MarJong/ECCO-Matrix/Bilder/metalldetektor.png

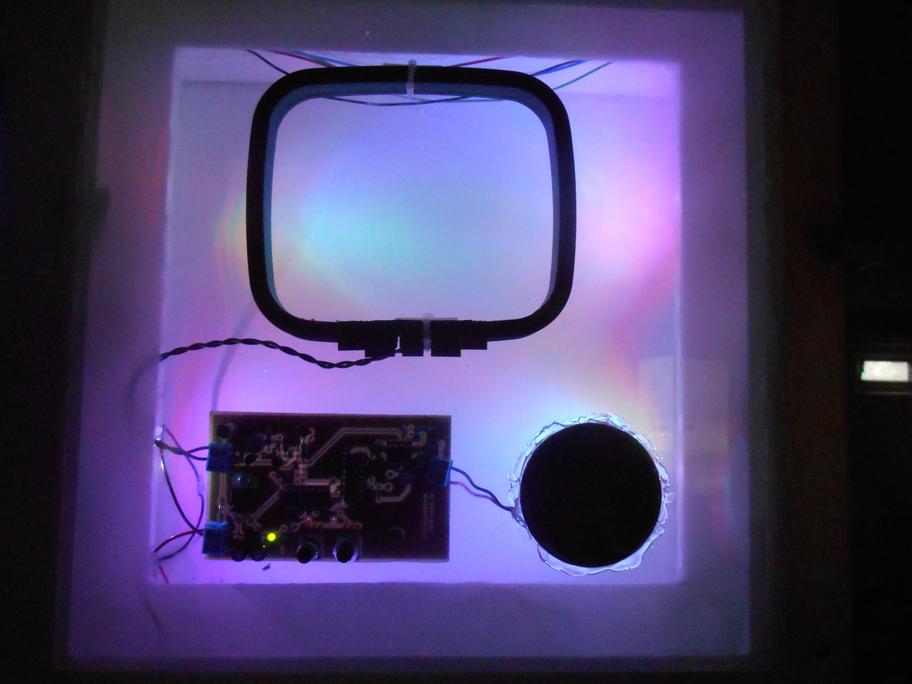
Bilder/metalldetektor.png
