MarJong/ECCO-Matrix/Bilder/mit gestrichener wand.png

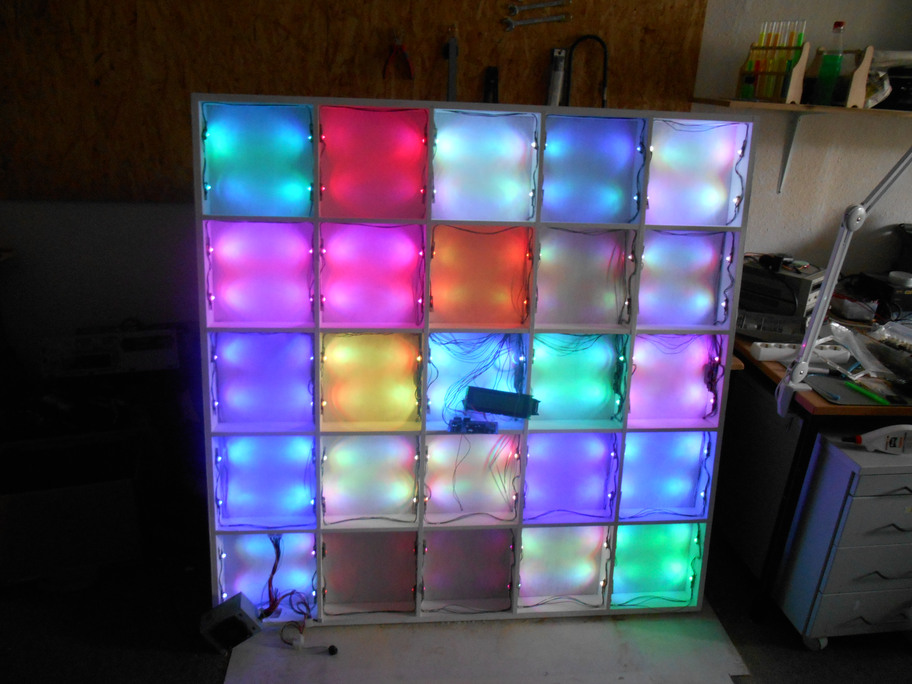
Bilder/mit gestrichener wand.png
