MarJong/ECCO-Matrix/README.md

# ECCO-Matrix
Archiv der Daten zum LED Matrix Ausstellungsstück des Elektronik Club Cottbus (ECCO)
