MarJong/ECCO-Matrix/Bilder/fertig 2.png

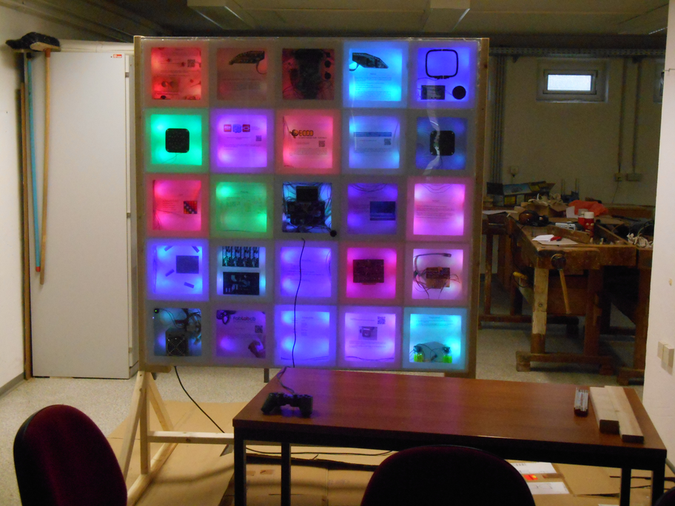
Bilder/fertig 2.png
