MarJong/ECCO-Matrix/Bilder/fertig .png

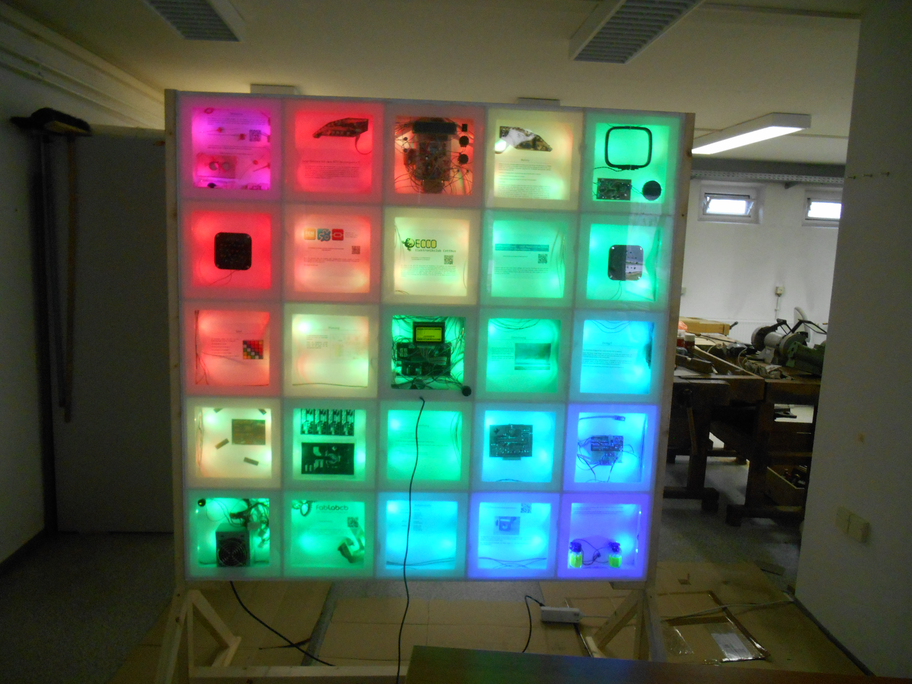
Bilder/fertig .png
