MarJong/ECCO-Matrix/Bilder/Hauptmenü.png

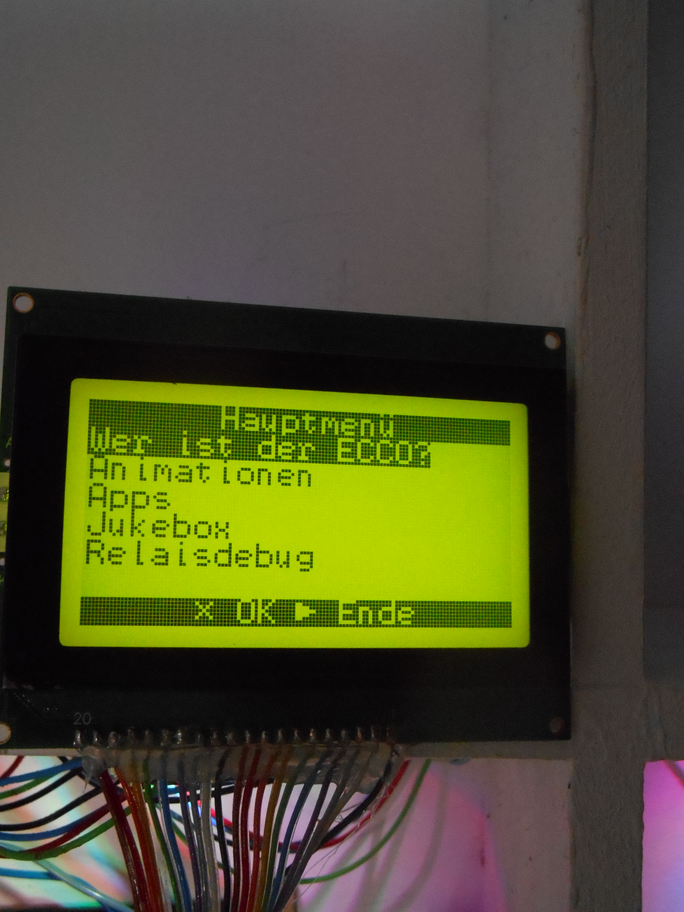
Bilder/Hauptmenü.png
