MarJong/ECCO-Matrix/Bilder/Hauptplatine 2.png

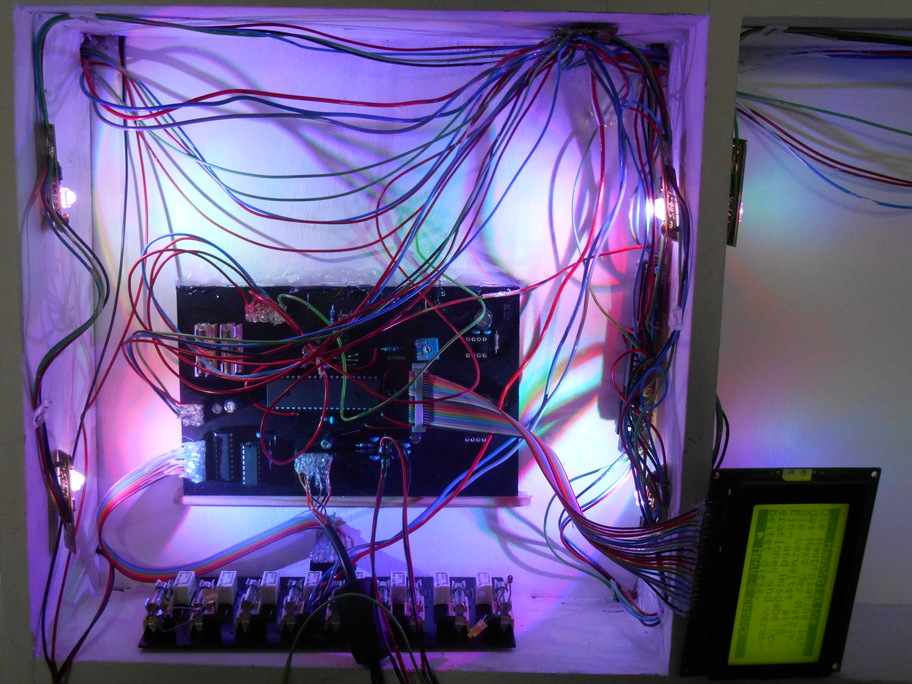
Bilder/Hauptplatine 2.png
