MarJong/ECCO-Matrix/Bilder/Hauptplatine.png

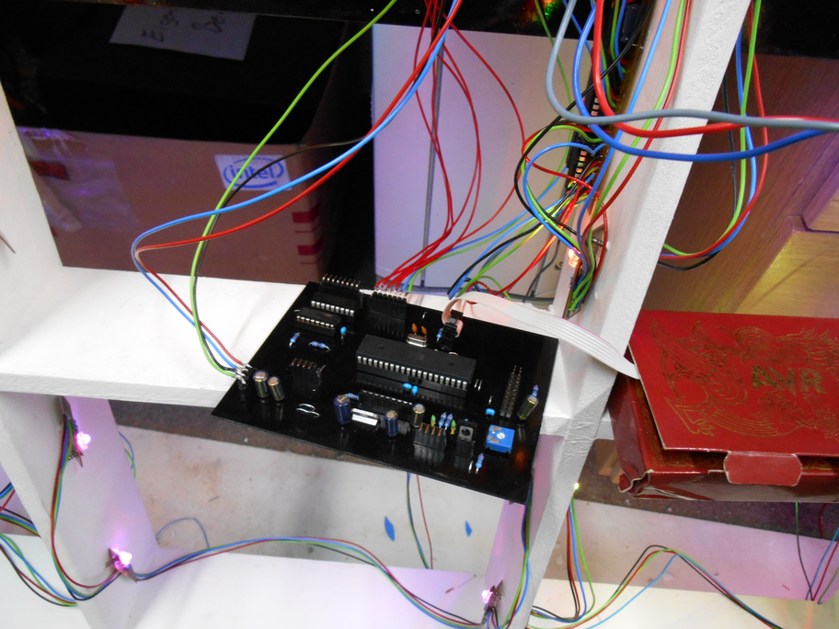
Bilder/Hauptplatine.png
