MarJong/ECCO-Matrix/Bilder/Matrix 1.png

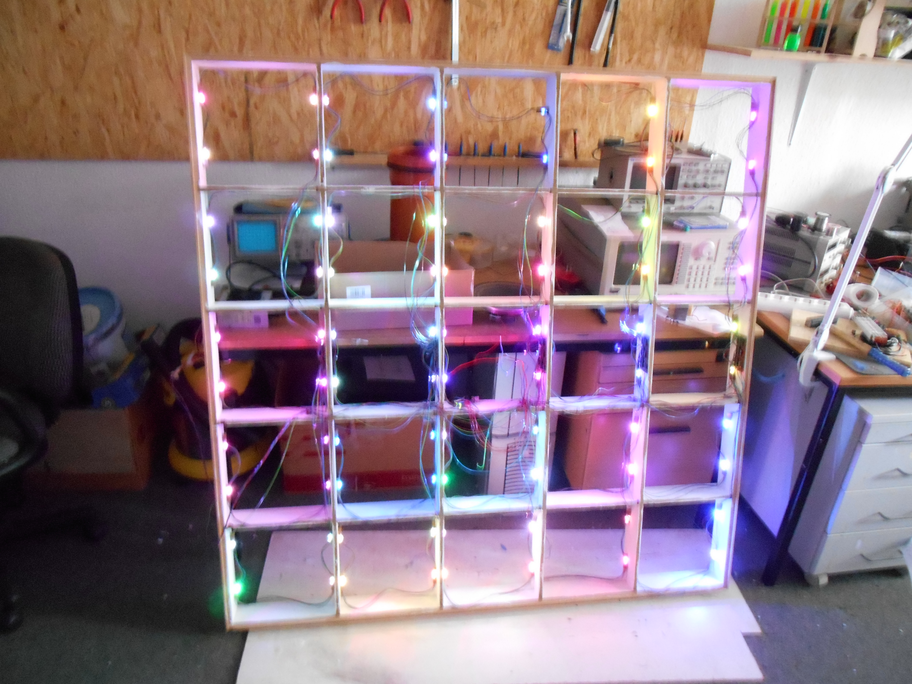
Bilder/Matrix 1.png
