MarJong/ECCO-Matrix/Bilder/Matrix 3.png

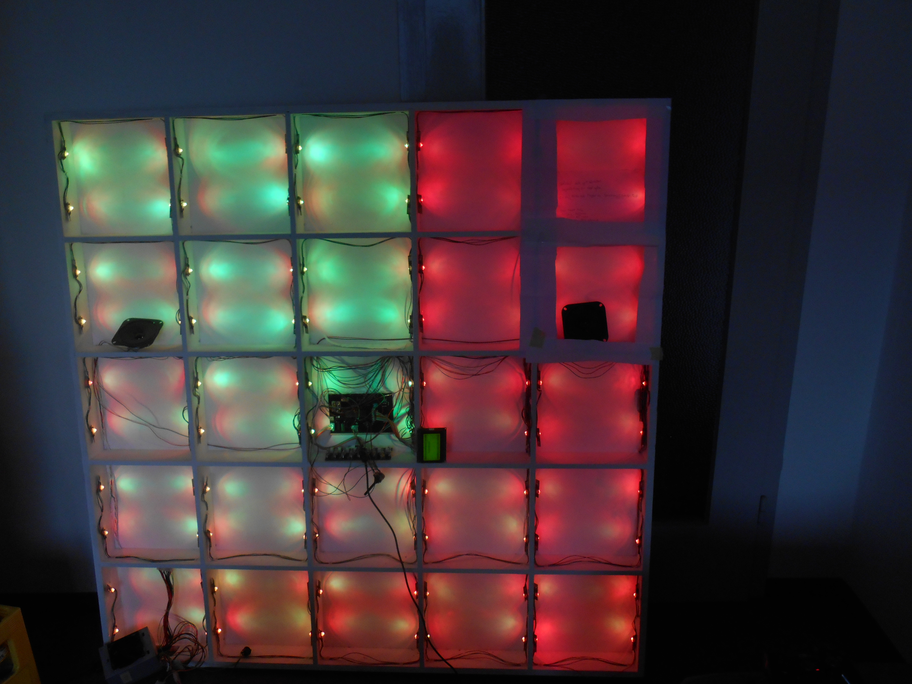
Bilder/Matrix 3.png
