MarJong/ECCO-Matrix/Bilder/Matrix Feld.png

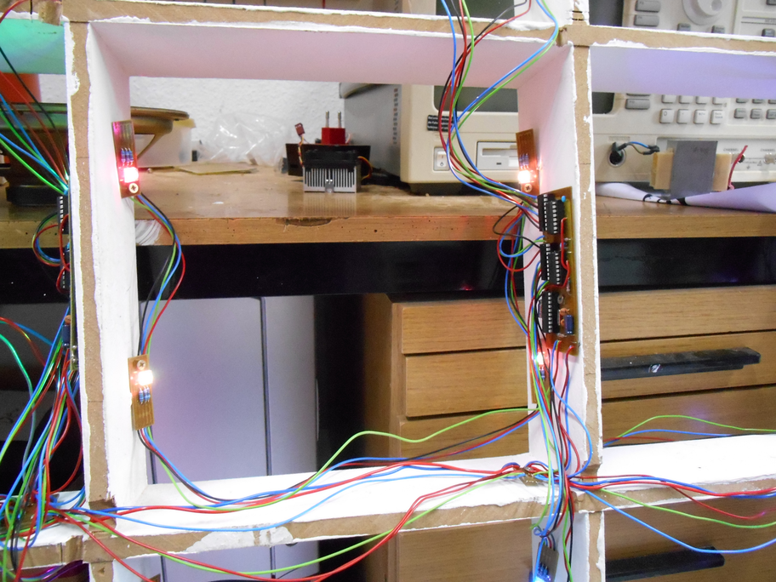
Bilder/Matrix Feld.png
