MarJong/ECCO-Matrix/Bilder/matrix mit rückwand.png

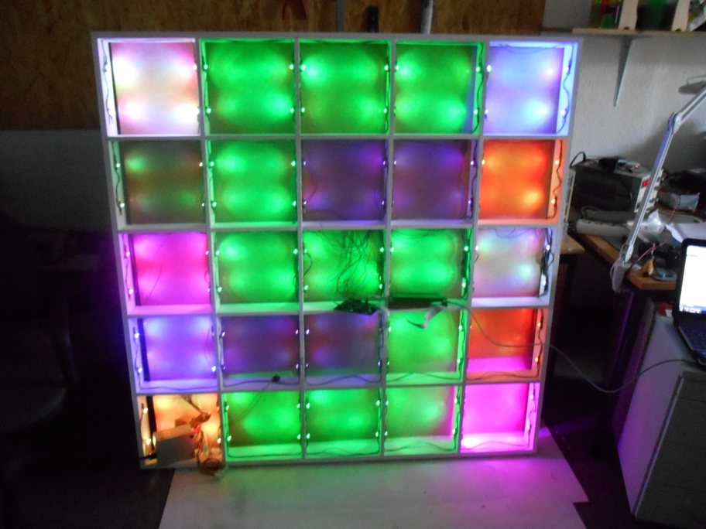
Bilder/matrix mit rückwand.png
