MarJong/ECCO-Matrix/Bilder/melete.png

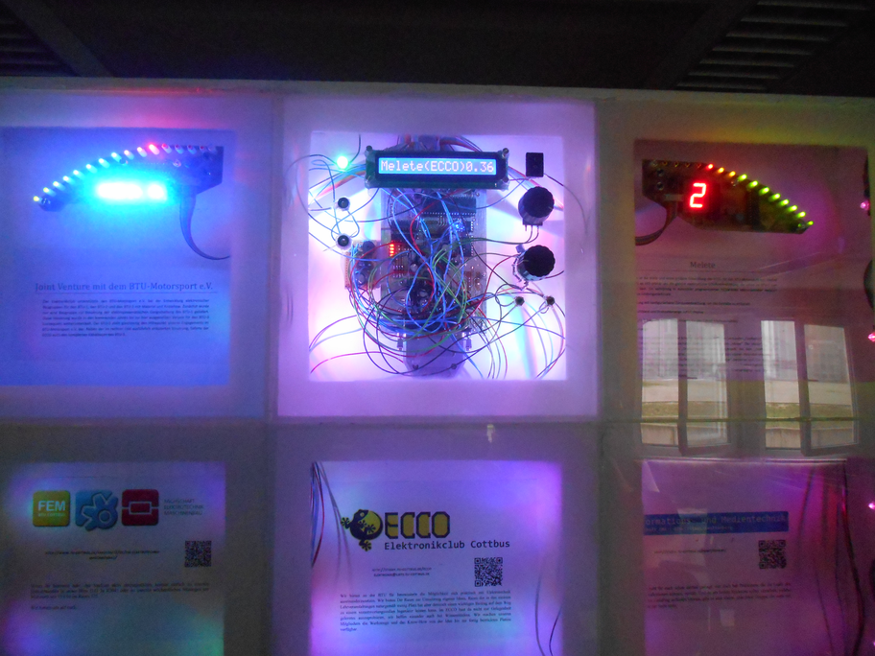
Bilder/melete.png
