MarJong/ECCO-Matrix/Bilder/mit farbe - ohne farbe.png

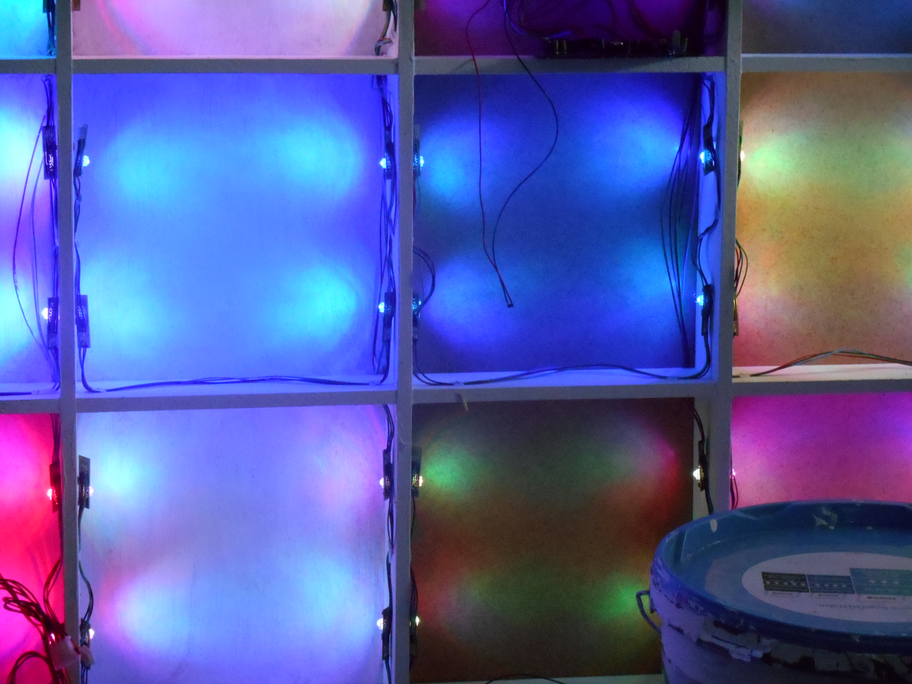
Bilder/mit farbe - ohne farbe.png
