MarJong/ECCO-Matrix/Bilder/Netzteil.png

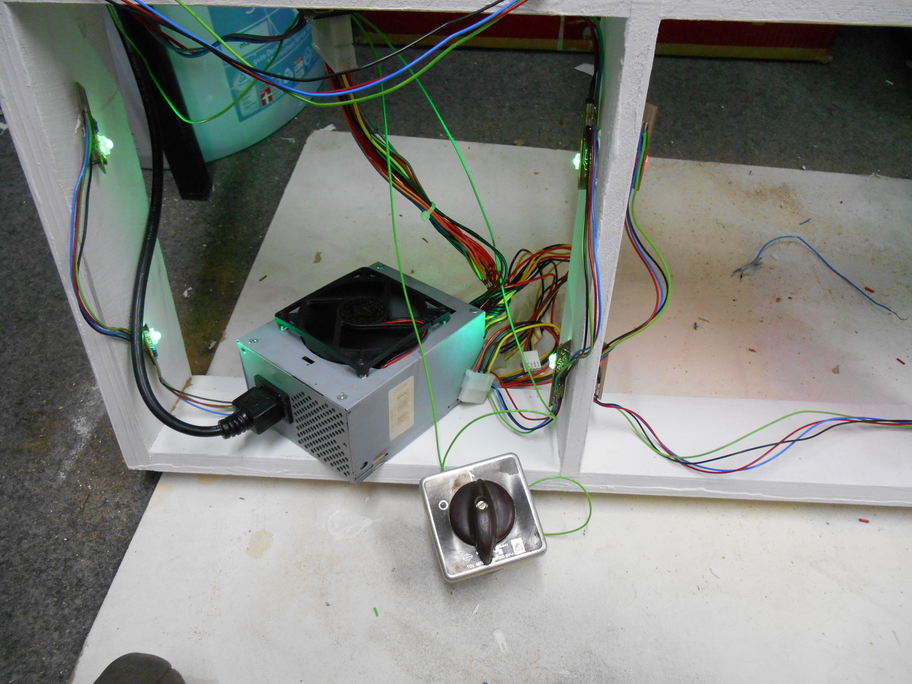
Bilder/Netzteil.png
