MarJong/ECCO-Matrix/Bilder/PWM Controller.png

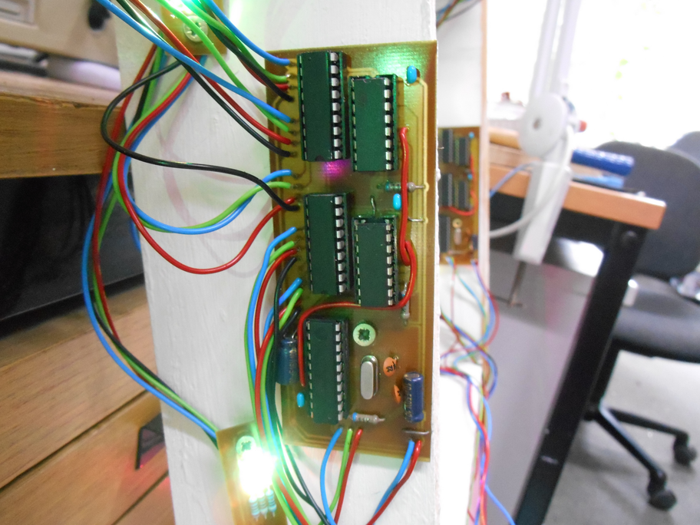
Bilder/PWM Controller.png
