MarJong/ECCO-Matrix/Bilder/uv dinger.png

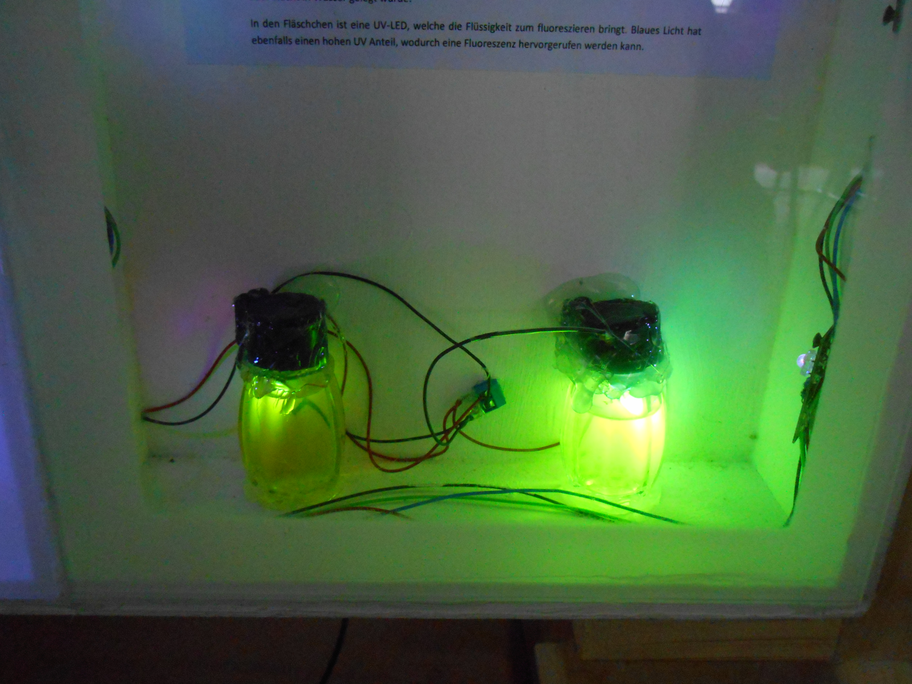
Bilder/uv dinger.png
