MarJong/ECCO-Matrix/Hardware/matrix - master.png

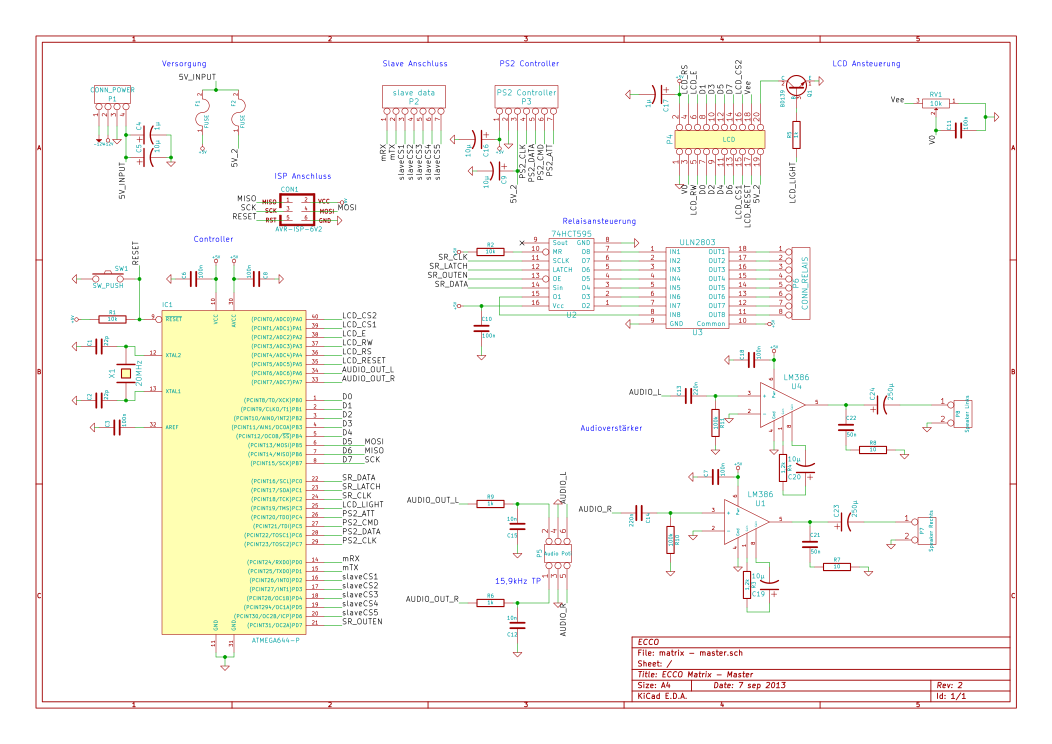
Hardware/matrix - master.png
