MarJong/ECCO-Matrix/Hardware/matrix - slave.png

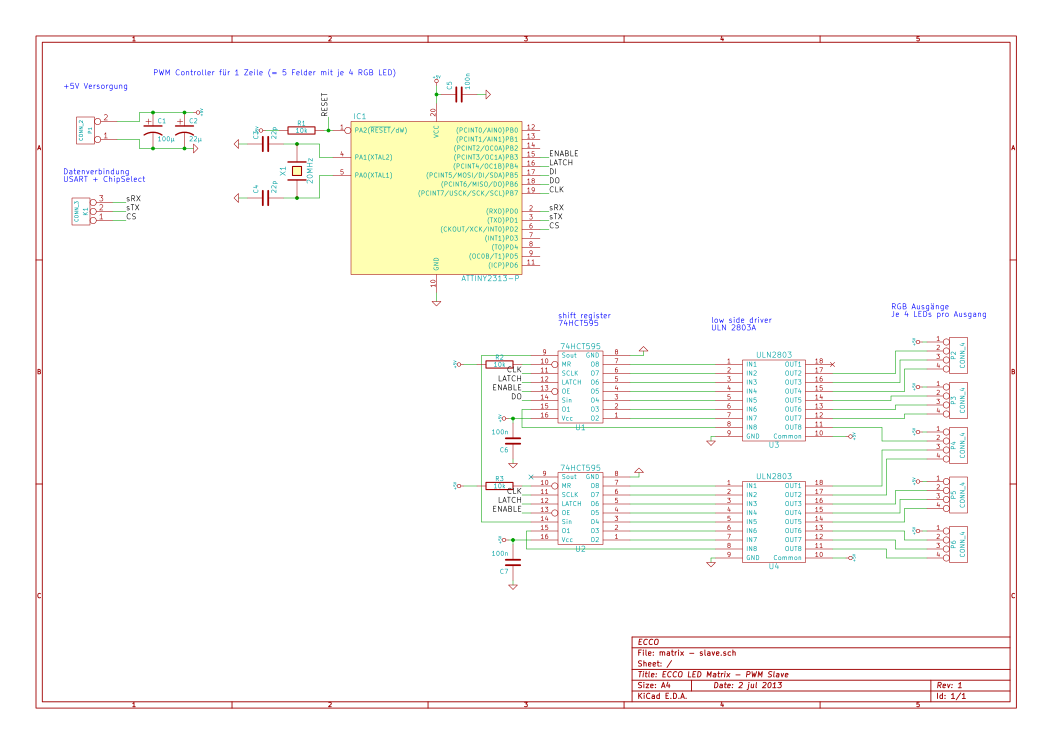
Hardware/matrix - slave.png
