MarJong/ECCO-Matrix/Hardware/matrix - master.pdf

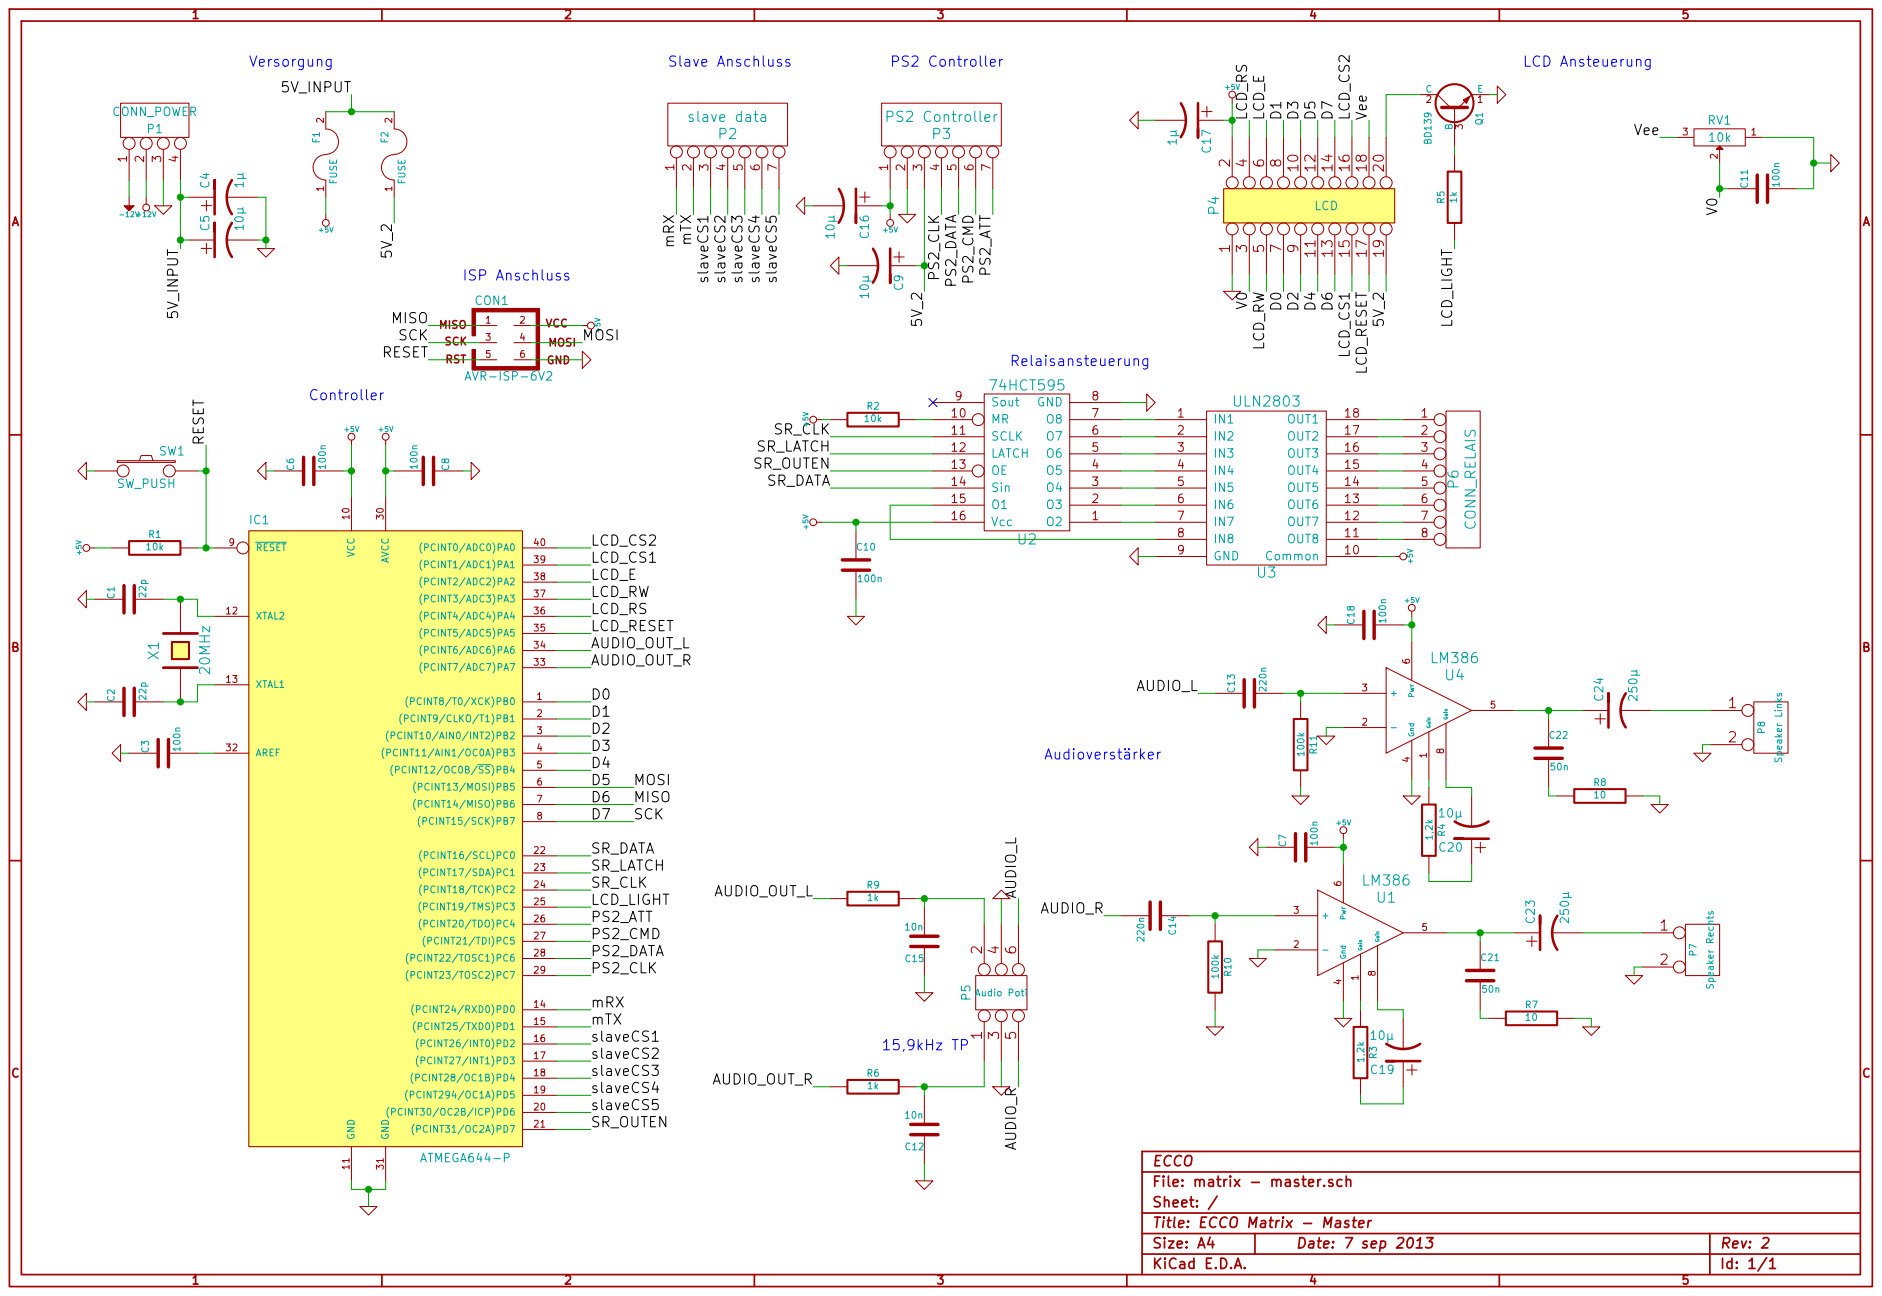
[picture p19: page 1]

IN2 2 | 2
IN3 3 | 3

IN5 5 | 5
IN6 6 | 6
IN7 7 | 7

ECCO
Title: ECCO Matrix - Master File: matrix - master.sch Sheet: /
