MarJong/ECCO-Matrix/Hardware/matrix - master.sch

## KiCad design Hardware/matrix - master.sch (2023-09-17)

Schematic: matrix - master.sch

Parts:
5V: Batterie
C1, C2: 22p
C3, C6, C7, C8, C10, C11, C18: 100n
C4, C17: 1µ
C5, C9, C16, C19, C20: 10µ
C12, C15: 10n
C13, C14: 220n
C21, C22: 50n
C23, C24: 250µ
CON1: AVR-ISP-6V2; AVR-ISP-6
F1, F2: FUSE
IC1: ATMEGA644-P; DIL40
P1: CONN_POWER
P2: slave data
P3: PS2 Controller
P4: LCD
P5: Audio Poti
P6: CONN_RELAIS
P7: Speaker Rechts
P8: Speaker Links
Q1: BD139; TO126
R1, R2: 10k
R3, R4: 1,2k
R5, R6, R9: 1k
R7, R8: 10
R10, R11: 100k
RV1: 10k
SW1: SW_PUSH
U1, U4: LM386
U2: 74HCT595
U3: ULN2803
X1: 20MHz

Notes on the sheet:
Controller
Versorgung
Slave Anschluss
PS2 Controller
Relaisansteuerung
LCD Ansteuerung
ISP Anschluss
15,9kHz TP
Audioverstärker
