MarJong/ECCO-Matrix/Hardware/matrix - relais.sch

## KiCad design Hardware/matrix - relais.sch (2023-09-17)


Parts:
F1, F2, F3, F4, F5, F6, F7, F8, F9, F10, F11, F12, F13, F14, F15, F16: FUSE
K1: CONN_POWER
K2, K3, K4, K5, K6, K7, K8, K9: CONN_OUT
P1: CONN_INPUT
R1: 10
R2: 20
RL1, RL2, RL3, RL4, RL5, RL6, RL7, RL8: FINDER-30.22

Connections:
5V_MASSE: R1.2, RL1.12, RL2.12, RL3.12, RL4.12, RL5.12, RL6.12, RL7.12, RL8.12
12V_MASSE: R2.2, RL1.22, RL2.22, RL3.22, RL4.22, RL5.22, RL6.22, RL7.22, RL8.22
+5V: K1.3, RL1.14, RL1.A1, RL2.14, RL2.A1, RL3.14, RL3.A1, RL4.14, RL4.A1, RL5.14, RL5.A1, RL6.14, RL6.A1, RL7.14, RL7.A1, RL8.14, RL8.A1
+12V: K1.2 (PM), RL1.24, RL2.24, RL3.24, RL4.24, RL5.24, RL6.24, RL7.24, RL8.24
GND: K1.1, K2.2 (PM), K3.2 (PM), K4.2 (PM), K5.2 (PM), K6.2 (PM), K7.2 (PM), K8.2 (PM), K9.2 (PM), R1.1, R2.1
IN1: P1.8, RL1.A2
IN2: P1.7, RL2.A2
IN3: P1.6, RL3.A2
IN4: P1.5, RL4.A2
IN5: P1.4, RL5.A2
IN6: P1.3, RL6.A2
IN7: P1.2, RL7.A2
IN8: P1.1, RL8.A2
unnamed: F1.1, RL1.21
unnamed: F1.2, K2.1
unnamed: F2.1, RL1.11
unnamed: F2.2, K2.3
unnamed: F3.1, RL2.21
unnamed: F3.2, K3.1
unnamed: F4.1, RL2.11
unnamed: F4.2, K3.3
unnamed: F5.1, RL3.21
unnamed: F5.2, K4.1
unnamed: F6.1, RL3.11
unnamed: F6.2, K4.3
unnamed: F7.1, RL4.21
unnamed: F7.2, K5.1
unnamed: F8.1, RL4.11
unnamed: F8.2, K5.3
unnamed: F9.1, RL5.21
unnamed: F9.2, K6.1
unnamed: F10.1, RL5.11
unnamed: F10.2, K6.3
unnamed: F11.1, RL6.21
unnamed: F11.2, K7.1
unnamed: F12.1, RL6.11
unnamed: F12.2, K7.3
unnamed: F13.1, RL7.21
unnamed: F13.2, K8.1
unnamed: F14.1, RL7.11
unnamed: F14.2, K8.3
unnamed: F15.1, RL8.21
unnamed: F15.2, K9.1
unnamed: F16.1, RL8.11
unnamed: F16.2, K9.3

Notes on the sheet:
Input
Versorgung
Absicherung Masse
