MarJong/ECCO-Matrix/Hardware/matrix - slave.sch

## KiCad design Hardware/matrix - slave.sch (2023-09-17)


Parts:
C1: 100µ
C2: 22µ
C3, C4: 22p
C5, C6, C7: 100n
IC1: ATTINY2313-P; DIP20
K1: CONN_3
P1: CONN_2
P2, P3, P4, P5, P6: CONN_4
R1, R2, R3: 10k
U1, U2: 74HCT595
U3, U4: ULN2803
X1: 20MHz

Connections:
+5V: C1.1, C2.1, C5.1, C6.2, C7.2, IC1.20 (VCC), P1.2 (PM), P2.1, P3.1, P4.1, P5.1, P6.1, R1.1, R2.1, R3.1, U1.16 (Vcc), U2.16 (Vcc), U3.10 (Common), U4.10 (Common)
CLK: IC1.19 ((PCINT7/USCK/SCK/SCL)PB7), U1.11 (SCLK), U2.11 (SCLK)
CS: IC1.6 ((CKOUT/XCK/INT0)PD2), K1.1
DI: IC1.17 ((PCINT5/MOSI/DI/SDA)PB5)
DO: IC1.18 ((PCINT6/MISO/DO)PB6), U1.14 (Sin)
ENABLE: IC1.15 ((PCINT3/OC1A)PB3), U1.13 (OE), U2.13 (OE)
GND: C1.2, C2.2, C3.1, C4.1, C5.2, C6.1, C7.1, IC1.10 (GND), P1.1, U1.8 (GND), U2.8 (GND), U3.9 (GND), U4.9 (GND)
LATCH: IC1.16 ((PCINT4/OC1B)PB4), U1.12 (LATCH), U2.12 (LATCH)
unnamed: C3.2, IC1.4 (PA1(XTAL2)), X1.2
unnamed: C4.2, IC1.5 (PA0(XTAL1)), X1.1
unnamed: P2.2, U3.17 (OUT2)
unnamed: P2.3, U3.16 (OUT3)
unnamed: P2.4, U3.15 (OUT4)
unnamed: P3.2, U3.14 (OUT5)
unnamed: P3.3, U3.13 (OUT6)
unnamed: P3.4, U3.12 (OUT7)
unnamed: P4.2, U3.11 (OUT8)
unnamed: P4.3, U4.18 (OUT1)
unnamed: P4.4, U4.17 (OUT2)
unnamed: P5.2, U4.16 (OUT3)
unnamed: P5.3, U4.15 (OUT4)
unnamed: P5.4, U4.14 (OUT5)
unnamed: P6.2, U4.13 (OUT6)
unnamed: P6.3, U4.12 (OUT7)
unnamed: P6.4, U4.11 (OUT8)
unnamed: R2.2, U1.10 (MR)
unnamed: R3.2, U2.10 (MR)
unnamed: U1.1 (O2), U3.7 (IN7)
unnamed: U1.2 (O3), U3.6 (IN6)
unnamed: U1.3 (O4), U3.5 (IN5)
unnamed: U1.4 (O5), U3.4 (IN4)
unnamed: U1.5 (O6), U3.3 (IN3)
unnamed: U1.6 (O7), U3.2 (IN2)
unnamed: U1.7 (O8), U3.1 (IN1)
unnamed: U1.9 (Sout), U2.14 (Sin)
unnamed: U1.15 (O1), U3.8 (IN8)
unnamed: U2.1 (O2), U4.7 (IN7)
unnamed: U2.2 (O3), U4.6 (IN6)
unnamed: U2.3 (O4), U4.5 (IN5)
unnamed: U2.4 (O5), U4.4 (IN4)
unnamed: U2.5 (O6), U4.3 (IN3)
unnamed: U2.6 (O7), U4.2 (IN2)
unnamed: U2.7 (O8), U4.1 (IN1)
unnamed: U2.15 (O1), U4.8 (IN8)
RESET: IC1.1 (PA2(~RESET~/dW)), R1.2
sRX: IC1.2 ((RXD)PD0), K1.3
sTX: IC1.3 ((TXD)PD1), K1.2 (PM)

Notes on the sheet:
shift register 74HCT595
low side driver ULN 2803A
Datenverbindung USART + ChipSelect
+5V Versorgung
RGB Ausgänge Je 4 LEDs pro Ausgang
PWM Controller für 1 Zeile (= 5 Felder mit je 4 RGB LED)
