MarJong/ECCO-Matrix/Hardware/matrix - stromanschluss.sch

## KiCad design Hardware/matrix - stromanschluss.sch (2023-09-17)


Parts:
P1: CONN_10X2
P2: CONN_5
P3: Switch
P4: CONN_1

Connections:
+3,3V: P1.17, P1.19, P1.20, P2.5
+5V: P1.2, P1.4, P1.9, P1.13, P2.3
+12V: P1.1, P2.1
-12V: P1.18, P2.4
GND: P1.7, P1.8, P1.10, P1.11, P1.12, P1.15, P1.16, P2.2, P3.2 (PM)
PS_ON: P1.14, P3.1
