MarJong/ECCO-Matrix/Hardware/matrix - verbinder.sch

## KiCad design Hardware/matrix - verbinder.sch (2023-09-17)

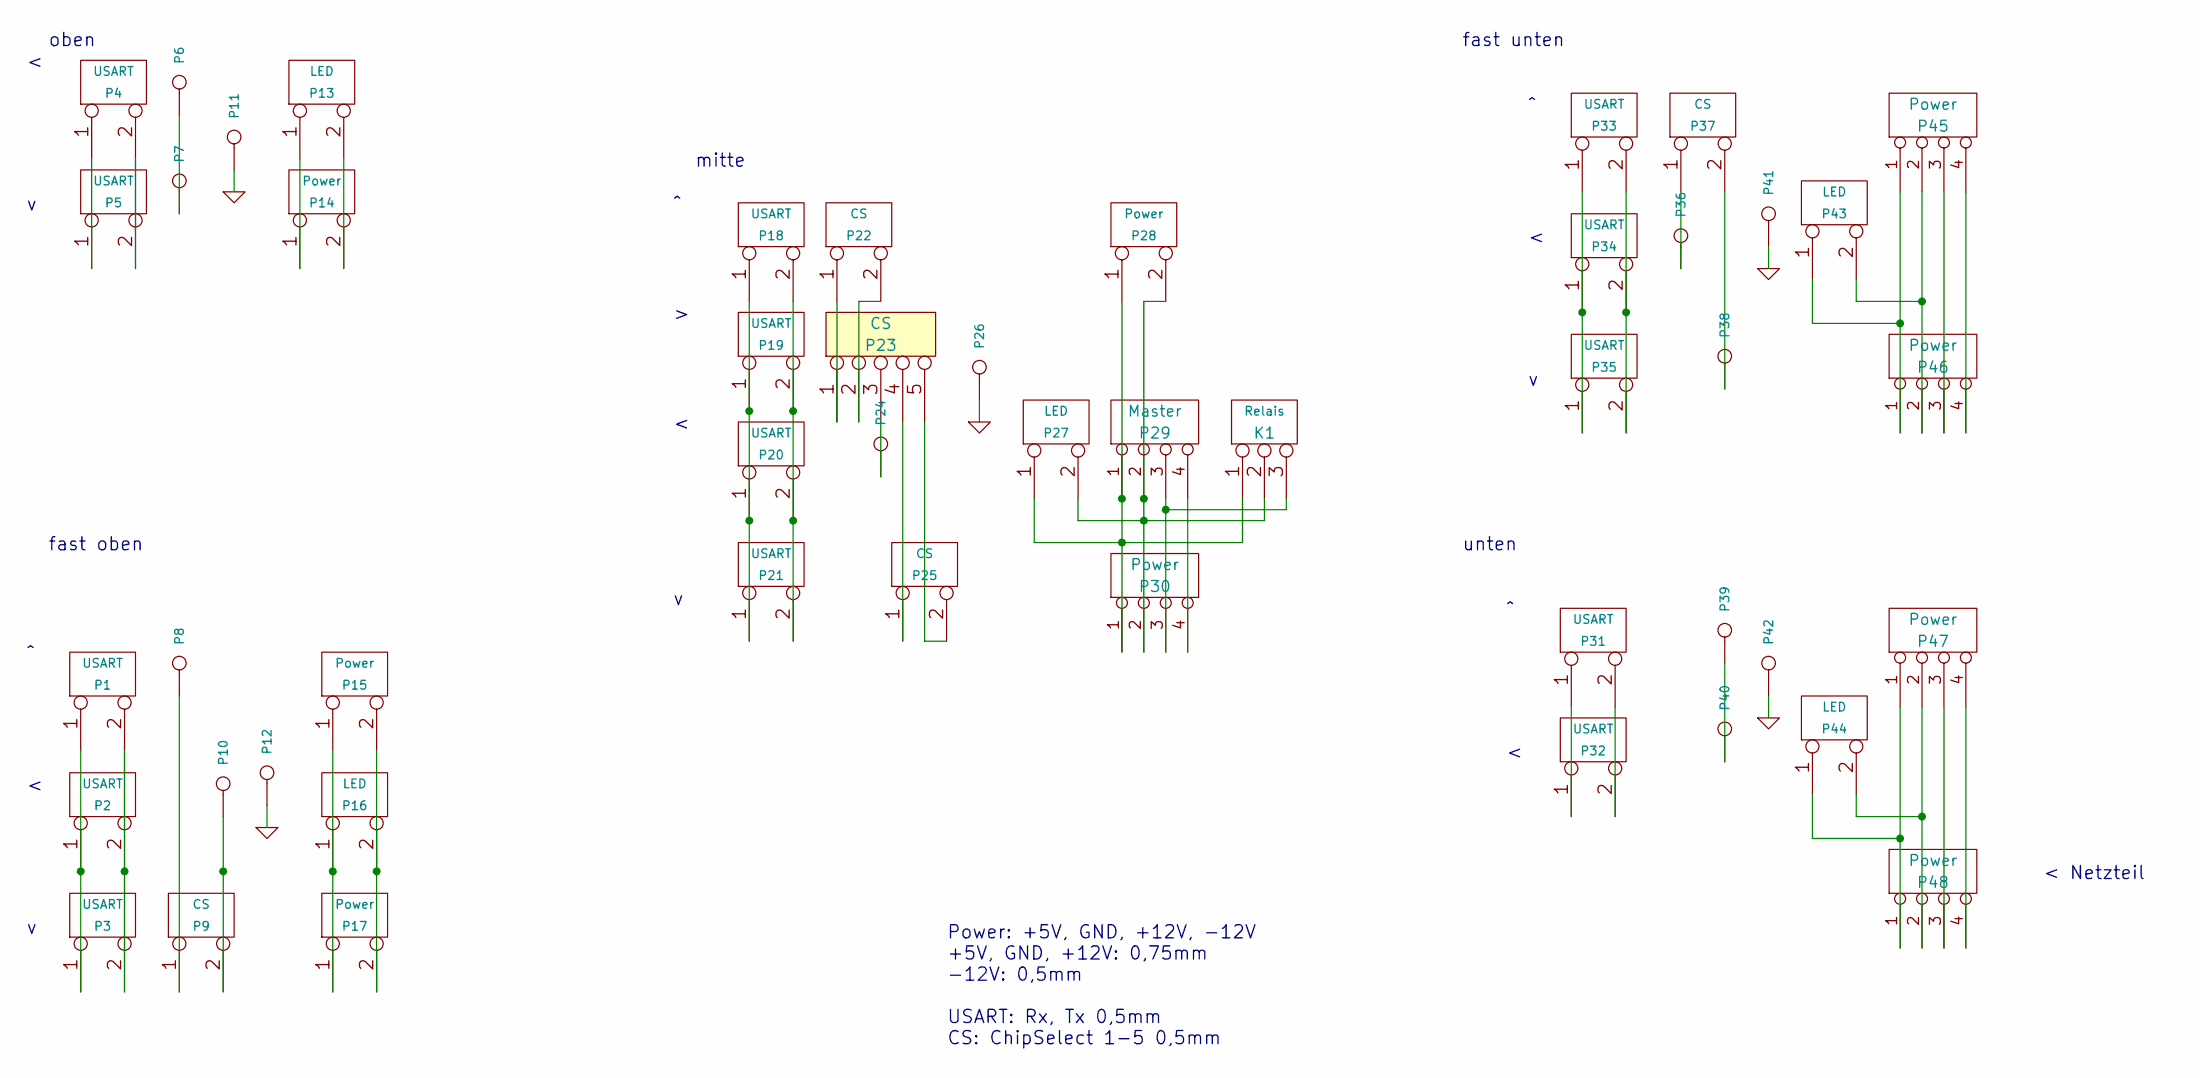
[picture p27: schematic matrix - verbinder.sch]

Parts:
K1: Relais
P1, P2, P3, P4, P5, P18, P19, P20, P21, P31, P32, P33, P34, P35: USART
P6, P7, P8, P9, P10, P22, P23, P24, P25, P36, P37, P38, P39, P40: CS
P11, P12, P26, P41, P42: schraube
P13, P16, P27, P43, P44: LED
P14, P15, P17, P28, P30, P45, P46, P47, P48: Power
P29: Master

Connections:
GND: P11.1, P12.1, P26.1, P41.1, P42.1
unnamed: K1.1, P27.1, P28.1, P29.1, P30.1
unnamed: K1.2 (PM), P27.2 (PM), P28.2 (PM), P29.2, P30.2
unnamed: K1.3, P29.3, P30.3
unnamed: P1.1, P2.1, P3.1
unnamed: P1.2 (PM), P2.2 (PM), P3.2 (PM)
unnamed: P4.1, P5.1
unnamed: P4.2 (PM), P5.2 (PM)
unnamed: P6.1, P7.1
unnamed: P8.1, P9.1
unnamed: P9.2 (PM), P10.1
unnamed: P13.1, P14.1
unnamed: P13.2 (PM), P14.2 (PM)
unnamed: P15.1, P16.1, P17.1
unnamed: P15.2 (PM), P16.2 (PM), P17.2 (PM)
unnamed: P18.1, P19.1, P20.1, P21.1
unnamed: P18.2 (PM), P19.2 (PM), P20.2 (PM), P21.2 (PM)
unnamed: P22.1, P23.1
unnamed: P22.2 (PM), P23.2
unnamed: P23.3, P24.1
unnamed: P23.4, P25.1
unnamed: P23.5, P25.2 (PM)
unnamed: P29.4, P30.4
unnamed: P31.1, P32.1
unnamed: P31.2 (PM), P32.2 (PM)
unnamed: P33.1, P34.1, P35.1
unnamed: P33.2 (PM), P34.2 (PM), P35.2 (PM)
unnamed: P36.1, P37.1
unnamed: P37.2 (PM), P38.1
unnamed: P39.1, P40.1
unnamed: P43.1, P45.1, P46.1
unnamed: P43.2 (PM), P45.2, P46.2
unnamed: P44.1, P47.1, P48.1
unnamed: P44.2 (PM), P47.2, P48.2
unnamed: P45.3, P46.3
unnamed: P45.4, P46.4
unnamed: P47.3, P48.3
unnamed: P47.4, P48.4

Notes on the sheet:
mitte
oben
fast oben
fast unten
unten
< Netzteil
Power: +5V, GND, +12V, -12V +5V, GND, +12V: 0,75mm -12V: 0,5mm USART: Rx, Tx 0,5mm CS: ChipSelect 1-5 0,5mm
