MarJong/ECCO-Matrix/Firmware - Master/ECCO Matrix - Master/audio_lieder.h

#ifndef AUDIO_LIEDER_H_
#define AUDIO_LIEDER_H_

#include <avr/io.h>
#include <avr/pgmspace.h>

#include "audio.h"

const note_t PROGMEM song_river_flows_in_you[519] = {
{15, 80}, {14, 20}, {19, 20}, {14, 20}, {21, 20}, {21, 80}, {21, 20}, {26, 10}, {22, 10}, {14, 20}, {15, 20}, {14, 20}, {15, 20}, {14, 20}, {19, 20}, 
{14, 20}, {21, 20}, {21, 80}, {21, 20}, {26, 10}, {22, 10}, {14, 20}, {15, 10}, {14, 10}, {14, 10}, {26, 10}, {15, 10}, {14, 10}, {14, 10}, {26, 10}, 
{19, 10}, {14, 10}, {14, 10}, {26, 10}, {21, 10}, {26, 10}, {22, 20}, {21, 20}, {19, 20}, {22, 20}, {24, 60}, {26, 10}, {27, 10}, {26, 40}, {26, 10}, 
{31, 10}, {26, 10}, {24, 10}, {22, 60}, {22, 10}, {21, 10}, {19, 60}, {21, 10}, {22, 10}, {24, 80}, {14, 20}, {15, 10}, {14, 10}, {14, 10}, {26, 10}, 
{15, 10}, {14, 10}, {14, 10}, {26, 10}, {19, 10}, {14, 10}, {14, 10}, {26, 10}, {21, 10}, {26, 10}, {22, 20}, {21, 20}, {19, 20}, {10, 20}, {12, 20}, 
{19, 20}, {12, 20}, {14, 10}, {15, 10}, {14, 60}, {26, 10}, {24, 10}, {22, 20}, {31, 20}, {26, 20}, {22, 10}, {21, 10}, {19, 20}, {31, 20}, {22, 20}, 
{21, 10}, {22, 10}, {24, 40}, {14, 10}, {12, 10}, {14, 10}, {15, 10}, {14, 10}, {26, 10}, {19, 10}, {26, 10}, {14, 10}, {12, 10}, {14, 10}, {15, 10}, 
{14, 10}, {26, 10}, {19, 10}, {26, 10}, {14, 10}, {12, 10}, {14, 10}, {15, 10}, {14, 10}, {12, 10}, {10, 10}, {9, 10}, {7, 10}, {10, 10}, {12, 10}, 
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
{11, 10}, {14, 5}, {16, 15}, {23, 10}, {23, 10}, {26, 5}, {28, 15}, {14, 5}, {20, 10}, {23, 5}, {21, 10}, {23, 10}, {45, 10}, {28, 10}, {23, 20}, 
};

#endif /* AUDIO_LIEDER_H_ */
